Embedded-3/iGuard/images/project_picture.png

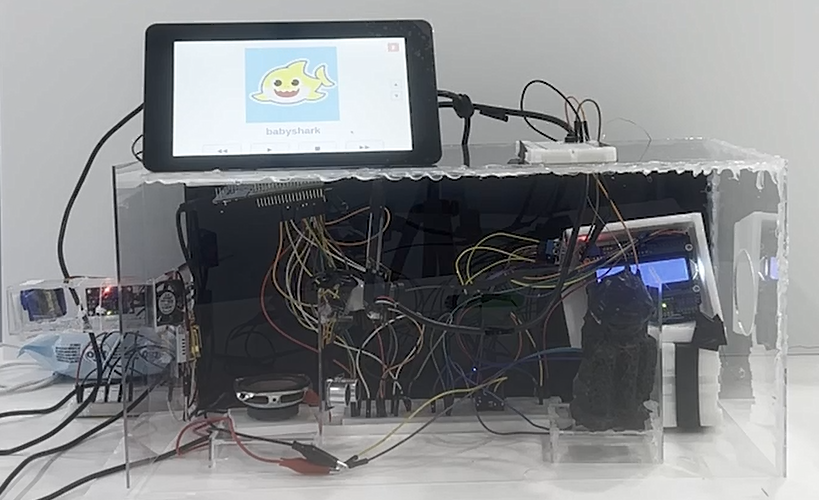
images/project_picture.png
