Embedded-3/iGuard/stm32_IVI/can_L0/Core/Inc/main.h

#define B1_Pin GPIO_PIN_13
#define B1_GPIO_Port GPIOC
#define B1_EXTI_IRQn EXTI4_15_IRQn
#define MCO_Pin GPIO_PIN_0
#define MCO_GPIO_Port GPIOH
#define USART_TX_Pin GPIO_PIN_2
#define USART_TX_GPIO_Port GPIOA
#define USART_RX_Pin GPIO_PIN_3
#define USART_RX_GPIO_Port GPIOA
#define LD2_Pin GPIO_PIN_5
#define LD2_GPIO_Port GPIOA
#define LCD_D6_Pin GPIO_PIN_10
#define LCD_D6_GPIO_Port GPIOB
#define LCD_E_Pin GPIO_PIN_7
#define LCD_E_GPIO_Port GPIOC
#define LCD_D7_Pin GPIO_PIN_8
#define LCD_D7_GPIO_Port GPIOA
#define LCD_RS_Pin GPIO_PIN_9
#define LCD_RS_GPIO_Port GPIOA
#define CAN_INT_Pin GPIO_PIN_10
#define CAN_INT_GPIO_Port GPIOA
#define CAN_INT_EXTI_IRQn EXTI4_15_IRQn
#define TMS_Pin GPIO_PIN_13
#define TMS_GPIO_Port GPIOA
#define TCK_Pin GPIO_PIN_14
#define TCK_GPIO_Port GPIOA
#define LCD_D5_Pin GPIO_PIN_4
#define LCD_D5_GPIO_Port GPIOB
#define LCD_D4_Pin GPIO_PIN_5
#define LCD_D4_GPIO_Port GPIOB
#define CAN_CS_Pin GPIO_PIN_6
#define CAN_CS_GPIO_Port GPIOB
