Embedded-3/iGuard/stm32_IVI/can_L0/Core/Src/main.c

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
/* Includes ------------------------------------------------------------------*/
#include "main.h"
#include "spi.h"
#include "usart.h"
#include "gpio.h"

/* USER CODE BEGIN Includes */
#include "CANSPI.h"
#include "lcd.h"
#include "stdio.h"
#include "MCP2515.h"
#include "DFPLAYER_MINI.h"
#include "string.h"
#include "hw_vcom.h"
/* USER CODE END Includes */

/* USER CODE BEGIN PD */
#define BUFSIZE 128
/* USER CODE END PD */


/* USER CODE BEGIN PV */
extern UART_HandleTypeDef huart2; // USART2
extern UART_HandleTypeDef huart4; // USART4
uCAN_MSG rxMessage;
/* USER CODE END PV */

void SystemClock_Config(void);
/* USER CODE BEGIN 0 */
volatile uint8_t can_rx_flag = 1;
volatile uint8_t driving_flag = 1;

void HAL_GPIO_EXTI_Callback(uint16_t GPIO_Pin)
{
	 if (GPIO_Pin == CAN_INT_Pin)  // PB9 INT
    {
				can_rx_flag = 1;
				HAL_ResumeTick();
    }
}
/* USER CODE END 0 */

/**
  * @brief  The application entry point.
  * @retval int
  */
int main(void)
{

  /* MCU Configuration--------------------------------------------------------*/

  /* Reset of all peripherals, Initializes the Flash interface and the Systick. */
  HAL_Init();

  /* Configure the system clock */
  SystemClock_Config();

  /* Initialize all configured peripherals */
  MX_GPIO_Init();
  MX_SPI1_Init();
  MX_USART2_UART_Init();
  MX_USART4_UART_Init();
  /* USER CODE BEGIN 2 */
	HW_VCOM_Init(&huart2);
	DF_Init(20);
  CANSPI_Initialize();	
	lcd_init();
	
	MCP2515_EnableInterrupts();
	
	DF_Resume();
  Printf("DF_Init finished\r\n");
  HAL_Delay(100);  
	
	Sound_Track(1);
	HAL_Delay(100);
	
  DF_Pause(); // pause
  Printf("DF_Pause \r\n");
  HAL_Delay(1000);
	Printf("now int pin : %d\r\n", HAL_GPIO_ReadPin(CAN_INT_GPIO_Port, CAN_INT_Pin));
	Printf("now driving mode : %d\r\n", driving_flag);
  
  static int lcdCnt = 0;
	static char buf[32];
	static uint8_t musicNumber;
	/* USER CODE END 2 */

  /* Infinite loop */
  /* USER CODE BEGIN WHILE */
  while (1)
  {
		// sleeping_mode
		if (driving_flag == 0 && can_rx_flag)
		{
				can_rx_flag = 0; 
				while(CANSPI_messagesInBuffer() > 0)
				{
					if (CANSPI_Receive(&rxMessage))
					{
						// Set song number from Raspberry pi CAN messege !!!!!!!!!!!!
						// STM32 check
						switch (rxMessage.frame.id)
						{
							// wakeup message 
							case 0x1:
								Printf("Wake up Message Received\r\n");
								break;
							// TextLcd message
							case 0x10:
								// store 8 bytes to buf
								Printf("%d th PrintLcd Message Received\r\n", lcdCnt + 1);
								if (lcdCnt < 4)
								{
										buf[lcdCnt * 8 + 0] = rxMessage.frame.data0;
										buf[lcdCnt * 8 + 1] = rxMessage.frame.data1;
										buf[lcdCnt * 8 + 2] = rxMessage.frame.data2;
										buf[lcdCnt * 8 + 3] = rxMessage.frame.data3;
										buf[lcdCnt * 8 + 4] = rxMessage.frame.data4;
										buf[lcdCnt * 8 + 5] = rxMessage.frame.data5;
										buf[lcdCnt * 8 + 6] = rxMessage.frame.data6;
										buf[lcdCnt * 8 + 7] = rxMessage.frame.data7;

										lcdCnt++;
								}

								// print lcd
								if (lcdCnt == 4)
								{
										buf[31] = '\0';  // null-terminate
										Printf("Print Message : %s\r\n", buf);
										lcd_clear();
										lcd_goto(0, 0); 
										lcd_print((char*)buf);  // buf[0~15]

										lcd_goto(1, 0);
										lcd_print((char*)&buf[16]); // buf[16~31]

										lcdCnt = 0;  // clear buf
								}
								break;
							// DFPlayer StartMusic
							case 0x05:
								musicNumber = rxMessage.frame.data0;
								Printf("%d Music Starts\r\n", musicNumber);
								if (musicNumber >= 1 && musicNumber <= 3)
								{
									Sound_Track(musicNumber);
								}
								break;
							// DFPlayer EndMusic
							case 0x06:
								Printf("Music Pauses\r\n");
								DF_Pause();
								break;
							// Resume Music
							case 0x07:
								Printf("Music Resume\r\n");
								DF_Resume();
								break;
							// DFPlayer Volume Up
							case 0x08:
								Printf("Music Volume Up\r\n");
								DF_Volume_Up();
								break;
							// DFPlayer Volume Down
							case 0x09:
								Printf("Music Volume Down\r\n");
								DF_Volume_Down();
								break;
							//  Sleep Message
							case 0x02:
								Printf("Goes to Sleep\r\n");
								HAL_SuspendTick();
								HAL_PWR_EnterSLEEPMode(PWR_MAINREGULATOR_ON, PWR_SLEEPENTRY_WFI);
								break;
							default:
								Printf("Default : %d\r\n", rxMessage.frame.id);
								break;
						}
					}		
				}
		}
		// driving mode
		else if (driving_flag && can_rx_flag)
		{
			can_rx_flag = 0;
			while(CANSPI_messagesInBuffer() > 0)
				{
					if (CANSPI_Receive(&rxMessage))
					{
						// Set song number from Raspberry pi CAN messege !!!!!!!!!!!!
						// STM32 check
						switch (rxMessage.frame.id)
						{
							// wakeup message 
							case 0x1:
								Printf("Wake up Message Received\r\n");
								break;
							// TextLcd message
							case 0x10:
								// store 8 bytes to buf
								Printf("%d th PrintLcd Message Received\r\n", lcdCnt + 1);
								if (lcdCnt < 4)
								{
										buf[lcdCnt * 8 + 0] = rxMessage.frame.data0;
										buf[lcdCnt * 8 + 1] = rxMessage.frame.data1;
										buf[lcdCnt * 8 + 2] = rxMessage.frame.data2;
										buf[lcdCnt * 8 + 3] = rxMessage.frame.data3;
										buf[lcdCnt * 8 + 4] = rxMessage.frame.data4;
										buf[lcdCnt * 8 + 5] = rxMessage.frame.data5;
										buf[lcdCnt * 8 + 6] = rxMessage.frame.data6;
										buf[lcdCnt * 8 + 7] = rxMessage.frame.data7;

										lcdCnt++;
								}

								// print lcd
								if (lcdCnt == 4)
								{
										buf[31] = '\0';  // null-terminate
										Printf("Print Message : %s\r\n", buf);
										lcd_clear();
										lcd_goto(0, 0); 
										lcd_print((char*)buf);  // buf[0~15]

										lcd_goto(1, 0);
										lcd_print((char*)&buf[16]); // buf[16~31]

										lcdCnt = 0;  // clear buf
								}
								break;
							// DFPlayer StartMusic
							case 0x05:
								musicNumber = rxMessage.frame.data0;
								Printf("%d Music Starts\r\n", musicNumber);
								if (musicNumber >= 1 && musicNumber <= 3)
								{
									Sound_Track(musicNumber);
								}
								break;
							// DFPlayer EndMusic
							case 0x06:
								Printf("Music Pauses\r\n");
								DF_Pause();
								break;
							// Resume Music
							case 0x07:
								Printf("Music Resume\r\n");
								DF_Resume();
								break;
							// DFPlayer Volume Up
							case 0x08:
								Printf("Music Volume Up\r\n");
								DF_Volume_Up();
								break;
							// DFPlayer Volume Down
							case 0x09:
								Printf("Music Volume Down\r\n");
								DF_Volume_Down();
								break;
							//  Sleep Message
							case 0x02:
								Printf("Goes to Sleep\r\n");
								driving_flag = 0;
								HAL_SuspendTick();
								HAL_PWR_EnterSLEEPMode(PWR_MAINREGULATOR_ON, PWR_SLEEPENTRY_WFI);
								break;
							default:
								Printf("Defuault : %d\r\n", rxMessage.frame.id);
								break;
						}
					}		
				}
		}
  }
    /* USER CODE END WHILE */

}

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
