Embedded-3/iGuard/stm32_IVI/can_L0/Core/Src/MCP2515.c

/*
    (c) 2016 Microchip Technology Inc. and its subsidiaries. You may use this
    software and any derivatives exclusively with Microchip products.

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
    IN NO EVENT WILL MICROCHIP BE LIABLE FOR ANY INDIRECT, SPECIAL, PUNITIVE,
    INCIDENTAL OR CONSEQUENTIAL LOSS, DAMAGE, COST OR EXPENSE OF ANY KIND
    WHATSOEVER RELATED TO THE SOFTWARE, HOWEVER CAUSED, EVEN IF MICROCHIP HAS
    BEEN ADVISED OF THE POSSIBILITY OR THE DAMAGES ARE FORESEEABLE. TO THE
    FULLEST EXTENT ALLOWED BY LAW, MICROCHIP'S TOTAL LIABILITY ON ALL CLAIMS IN
    ANY WAY RELATED TO THIS SOFTWARE WILL NOT EXCEED THE AMOUNT OF FEES, IF ANY,
    THAT YOU HAVE PAID DIRECTLY TO MICROCHIP FOR THIS SOFTWARE.

    MICROCHIP PROVIDES THIS SOFTWARE CONDITIONALLY UPON YOUR ACCEPTANCE OF THESE
    TERMS.
*/

#include "MCP2515.h"
#include "gpio.h"

/* SPI related variables */
extern SPI_HandleTypeDef        hspi1;
#define SPI_CAN                 &hspi1
#define SPI_TIMEOUT             10
#define MCP2515_CS_HIGH()   HAL_GPIO_WritePin(CAN_CS_GPIO_Port, CAN_CS_Pin, GPIO_PIN_SET)
#define MCP2515_CS_LOW()    HAL_GPIO_WritePin(CAN_CS_GPIO_Port, CAN_CS_Pin, GPIO_PIN_RESET)

/* Prototypes */
static void SPI_Tx(uint8_t data);
static void SPI_TxBuffer(uint8_t *buffer, uint8_t length);
static uint8_t SPI_Rx(void);
static void SPI_RxBuffer(uint8_t *buffer, uint8_t length);

/* initialize MCP2515 */
bool MCP2515_Initialize(void)
{
  MCP2515_CS_HIGH();    
  
  uint8_t loop = 10;
  
  do {
    /* check SPI Ready */
    if(HAL_SPI_GetState(SPI_CAN) == HAL_SPI_STATE_READY)
      return true;
    
    loop--;
  } while(loop > 0);

  // 초기화 시점: 수신된 메시지 내용은 무시하고 플래그만 정리
  MCP2515_BitModify(MCP2515_CANINTF, 0x03, 0x00); // RX0IF | RX1IF 클리어

  return false;
}

/* change mode as configuration mode */
bool MCP2515_SetConfigMode(void)
{
  /* configure CANCTRL Register */
  MCP2515_WriteByte(MCP2515_CANCTRL, 0x80);
  
  uint8_t loop = 10;
  
  do {    
    /* confirm mode configuration */
    if((MCP2515_ReadByte(MCP2515_CANSTAT) & 0xE0) == 0x80)
      return true;
    
    loop--;
  } while(loop > 0); 
  
  return false;
}

/* change mode as normal mode */
bool MCP2515_SetNormalMode(void)
{
  /* configure CANCTRL Register */
  MCP2515_WriteByte(MCP2515_CANCTRL, 0x00);
  
  uint8_t loop = 10;
  
  do {    
    /* confirm mode configuration */
    if((MCP2515_ReadByte(MCP2515_CANSTAT) & 0xE0) == 0x00)
      return true;
    
    loop--;
  } while(loop > 0);
  
  return false;
}

/* Entering sleep mode */
bool MCP2515_SetSleepMode(void)
{
  /* configure CANCTRL Register */
  MCP2515_WriteByte(MCP2515_CANCTRL, 0x20);
  
  uint8_t loop = 10;
  
  do {    
    /* confirm mode configuration */
    if((MCP2515_ReadByte(MCP2515_CANSTAT) & 0xE0) == 0x20)
      return true;
    
    loop--;
  } while(loop > 0);
  
  return false;
}

/* MCP2515 SPI-Reset */
void MCP2515_Reset(void)
{    
  MCP2515_CS_LOW();
      
  SPI_Tx(MCP2515_RESET);
      
  MCP2515_CS_HIGH();
}

/* read single byte */
uint8_t MCP2515_ReadByte (uint8_t address)
{
  uint8_t retVal;
  
  MCP2515_CS_LOW();
  
  SPI_Tx(MCP2515_READ);
  SPI_Tx(address);
  retVal = SPI_Rx();
      
  MCP2515_CS_HIGH();
  
  return retVal;
}

/* read buffer */
void MCP2515_ReadRxSequence(uint8_t instruction, uint8_t *data, uint8_t length)
{
  MCP2515_CS_LOW();
  
  SPI_Tx(instruction);        
  SPI_RxBuffer(data, length);
    
  MCP2515_CS_HIGH();
}

/* write single byte */
void MCP2515_WriteByte(uint8_t address, uint8_t data)
{    
  MCP2515_CS_LOW();  
  
  SPI_Tx(MCP2515_WRITE);
  SPI_Tx(address);
  SPI_Tx(data);  
    
  MCP2515_CS_HIGH();
}

/* write buffer */
void MCP2515_WriteByteSequence(uint8_t startAddress, uint8_t endAddress, uint8_t *data)
{    
  MCP2515_CS_LOW();
  
  SPI_Tx(MCP2515_WRITE);
  SPI_Tx(startAddress);
  SPI_TxBuffer(data, (endAddress - startAddress + 1));
  
  MCP2515_CS_HIGH();
}

/* write to TxBuffer */
void MCP2515_LoadTxSequence(uint8_t instruction, uint8_t *idReg, uint8_t dlc, uint8_t *data)
{    
  MCP2515_CS_LOW();
  
  SPI_Tx(instruction);
  SPI_TxBuffer(idReg, 4);
  SPI_Tx(dlc);
  SPI_TxBuffer(data, dlc);
       
  MCP2515_CS_HIGH();
}

/* write to TxBuffer(1 byte) */
void MCP2515_LoadTxBuffer(uint8_t instruction, uint8_t data)
{
  MCP2515_CS_LOW();
  
  SPI_Tx(instruction);
  SPI_Tx(data);
        
  MCP2515_CS_HIGH();
}

/* request to send */
void MCP2515_RequestToSend(uint8_t instruction)
{
  MCP2515_CS_LOW();
  
  SPI_Tx(instruction);
      
  MCP2515_CS_HIGH();
}

/* read status */
uint8_t MCP2515_ReadStatus(void)
{
  uint8_t retVal;
  
  MCP2515_CS_LOW();
  
  SPI_Tx(MCP2515_READ_STATUS);
  retVal = SPI_Rx();
        
  MCP2515_CS_HIGH();
  
  return retVal;
}

/* read RX STATUS register */
uint8_t MCP2515_GetRxStatus(void)
{
  uint8_t retVal;
  
  MCP2515_CS_LOW();
  
  SPI_Tx(MCP2515_RX_STATUS);
  retVal = SPI_Rx();
        
  MCP2515_CS_HIGH();
  
  return retVal;
}

/* Use when changing register value */
void MCP2515_BitModify(uint8_t address, uint8_t mask, uint8_t data)
{    
  MCP2515_CS_LOW();
  
  SPI_Tx(MCP2515_BIT_MOD);
  SPI_Tx(address);
  SPI_Tx(mask);
  SPI_Tx(data);
        
  MCP2515_CS_HIGH();
}

/* SPI Tx wrapper function  */
static void SPI_Tx(uint8_t data)
{
  HAL_SPI_Transmit(SPI_CAN, &data, 1, SPI_TIMEOUT);    
}

/* SPI Tx wrapper function */
static void SPI_TxBuffer(uint8_t *buffer, uint8_t length)
{
  HAL_SPI_Transmit(SPI_CAN, buffer, length, SPI_TIMEOUT);    
}

/* SPI Rx wrapper function */
static uint8_t SPI_Rx(void)
{
  uint8_t retVal;
  HAL_SPI_Receive(SPI_CAN, &retVal, 1, SPI_TIMEOUT);
  return retVal;
}

/* SPI Rx wrapper function */
static void SPI_RxBuffer(uint8_t *buffer, uint8_t length)
{
  HAL_SPI_Receive(SPI_CAN, buffer, length, SPI_TIMEOUT);
}

/* HyunHo Custom */
#define MCP2515_READ_RX_BUFFER_0  0x90  // Read RX Buffer 0: Start from RXB0SIDH
#define MCP2515_READ_RX_BUFFER_1  0x94  // Read RX Buffer 1: Start from RXB1SIDH
void MCP2515_EnableInterrupts(void)
{
    // SET RX0IE | RX1IE bit to 1(0x01 | 0x02 = 0x03)
    MCP2515_WriteByte(MCP2515_CANINTE, 0x03);
}


void MCP2515_ReadCANMessage(void)
{
    uint8_t intf = MCP2515_ReadByte(MCP2515_CANINTF);

    if (intf & 0x01)  // RX0IF
    {
        uint8_t data[13];  // SIDH, SIDL, EID8, EID0, DLC, data(8???)
        MCP2515_ReadRxSequence(MCP2515_READ_RX_BUFFER_0, data, 13);

        MCP2515_BitModify(MCP2515_CANINTF, 0x01, 0x00);  // RX0IF 
    }

    if (intf & 0x02)  // RX1IF
    {
        uint8_t data[13];
        MCP2515_ReadRxSequence(MCP2515_READ_RX_BUFFER_1, data, 13);
			
        MCP2515_BitModify(MCP2515_CANINTF, 0x02, 0x00);  // RX1IF 
    }
}
