Embedded-3/iGuard/tc275_hvac/asclin_driver/asclin.c

// asclin.c
#include <asclin_driver/asclin.h>
#include "Ifx_Types.h"
#include "IfxAsclin_Asc.h"
#include "Ifx_Shell.h"
#include "Ifx_Console.h"
#include "IfxPort.h"



// Global variables
IfxStdIf_DPipe  g_ascStandardInterface;                                     /* Standard interface object            */
IfxAsclin_Asc   g_asclin;                                                   /* ASCLIN module object                 */
Ifx_Shell       g_shellInterface;                                           /* Shell interface object               */

uint8 g_uartTxBuffer[ASC_TX_BUFFER_SIZE + sizeof(Ifx_Fifo) + 8];
uint8 g_uartRxBuffer[ASC_RX_BUFFER_SIZE + sizeof(Ifx_Fifo) + 8];


IfxStdIf_DPipe* stdif = &g_ascStandardInterface;    // To use other file

// Function Implementations
// IFX_INTERRUPT
IFX_INTERRUPT(asc3TxISR, 0, ISR_PRIORITY_ASCLIN_TX);

void asc3TxISR(void)
{
    IfxStdIf_DPipe_onTransmit(&g_ascStandardInterface);
}

IFX_INTERRUPT(asc3RxISR, 0, ISR_PRIORITY_ASCLIN_RX);

void asc3RxISR(void)
{
    IfxStdIf_DPipe_onReceive(&g_ascStandardInterface);
}

IFX_INTERRUPT(asc3ErrISR, 0, ISR_PRIORITY_ASCLIN_ER);

void asc3ErrISR(void)
{
    IfxStdIf_DPipe_onError(&g_ascStandardInterface);
}



void initShellInterface(void)
{
    /* Initialize the hardware peripherals */
    initSerialInterface();

    /* Initialize the Standard Interface */
    IfxAsclin_Asc_stdIfDPipeInit(&g_ascStandardInterface, &g_asclin);

    /* Initialize the Console */
    Ifx_Console_init(&g_ascStandardInterface);

    /* Print info to the console */
    printInfo(&g_ascStandardInterface);
}


void initSerialInterface(void)
{
    IfxAsclin_Asc_Config ascConf;

    /* Set default configurations */
    IfxAsclin_Asc_initModuleConfig(&ascConf, &MODULE_ASCLIN3); /* Initialize the structure with default values      */

    /* Set the desired baud rate */
    ascConf.baudrate.baudrate = ASC_BAUDRATE;                                   /* Set the baud rate in bit/s       */
    ascConf.baudrate.oversampling = IfxAsclin_OversamplingFactor_16;            /* Set the oversampling factor      */

    /* Configure the sampling mode */
    ascConf.bitTiming.medianFilter = IfxAsclin_SamplesPerBit_three;             /* Set the number of samples per bit*/
    ascConf.bitTiming.samplePointPosition = IfxAsclin_SamplePointPosition_8;    /* Set the first sample position    */

    /* ISR priorities and interrupt target */
    ascConf.interrupt.txPriority = ISR_PRIORITY_ASCLIN_TX;  /* Set the interrupt priority for TX events             */
    ascConf.interrupt.rxPriority = ISR_PRIORITY_ASCLIN_RX;  /* Set the interrupt priority for RX events             */
    ascConf.interrupt.erPriority = ISR_PRIORITY_ASCLIN_ER;  /* Set the interrupt priority for Error events          */
    ascConf.interrupt.typeOfService = IfxSrc_Tos_cpu0;

    /* Pin configuration */
    const IfxAsclin_Asc_Pins pins = {
            .cts        = NULL_PTR,                         /* CTS pin not used                                     */
            .ctsMode    = IfxPort_InputMode_pullUp,
            .rx         = &IfxAsclin3_RXD_P32_2_IN ,        /* Select the pin for RX connected to the USB port      */
            .rxMode     = IfxPort_InputMode_pullUp,         /* RX pin                                               */
            .rts        = NULL_PTR,                         /* RTS pin not used                                     */
            .rtsMode    = IfxPort_OutputMode_pushPull,
            .tx         = &IfxAsclin3_TX_P15_7_OUT,         /* Select the pin for TX connected to the USB port      */
            .txMode     = IfxPort_OutputMode_pushPull,      /* TX pin                                               */
            .pinDriver  = IfxPort_PadDriver_cmosAutomotiveSpeed1
    };
    ascConf.pins = &pins;

    /* FIFO buffers configuration */
    ascConf.txBuffer = g_uartTxBuffer;                      /* Set the transmission buffer                          */
    ascConf.txBufferSize = ASC_TX_BUFFER_SIZE;              /* Set the transmission buffer size                     */
    ascConf.rxBuffer = g_uartRxBuffer;                      /* Set the receiving buffer                             */
    ascConf.rxBufferSize = ASC_RX_BUFFER_SIZE;              /* Set the receiving buffer size                        */

    /* Init ASCLIN module */
    IfxAsclin_Asc_initModule(&g_asclin, &ascConf);          /* Initialize the module with the given configuration   */
}


void printInfo(IfxStdIf_DPipe *io)
{
    IfxStdIf_DPipe_print(io, ENDLINE);
    IfxStdIf_DPipe_print(io, "******************************************************************************"ENDLINE);
    IfxStdIf_DPipe_print(io, "[ Serial DEBUG ]  "ENDLINE);
    IfxStdIf_DPipe_print(io, "******************************************************************************"ENDLINE);
}
