Embedded-3/iGuard/tc275_hvac/mq135_driver/mq135.c

// mq135.c

#include "mq135.h"


static void Driver_Adc0_Init(void);

App_VadcAutoScan g_VadcAutoScan;
IfxVadc_Adc_ChannelConfig adcChannelConfig[8];
IfxVadc_Adc_Channel   adcChannel[8];
uint16 adcDataResult[8] = {0u,};

// 핀 설정 : 핀 A2
uint32 chnIx = 5; //7;
uint16 groutId = IfxVadc_GroupId_4;



static void Driver_Adc0_Init(void)
{
    /* VADC Configuration */

    /* create configuration */
    IfxVadc_Adc_Config adcConfig;
    IfxVadc_Adc_initModuleConfig(&adcConfig, &MODULE_VADC);

    /* initialize module */
    IfxVadc_Adc_initModule(&g_VadcAutoScan.vadc, &adcConfig);

    /* create group config */
    IfxVadc_Adc_GroupConfig adcGroupConfig;
    IfxVadc_Adc_initGroupConfig(&adcGroupConfig, &g_VadcAutoScan.vadc);

    /* with group 0 */
    adcGroupConfig.groupId = groutId;   // groupId 4
    adcGroupConfig.master  = adcGroupConfig.groupId;

    /* enable scan source */
    adcGroupConfig.arbiter.requestSlotScanEnabled = TRUE;

    /* enable auto scan */
    adcGroupConfig.scanRequest.autoscanEnabled = TRUE;

    /* enable all gates in "always" mode (no edge detection) */
    adcGroupConfig.scanRequest.triggerConfig.gatingMode = IfxVadc_GatingMode_always;

    /* initialize the group */
    /*IfxVadc_Adc_Group adcGroup;*/    //declared globally
    IfxVadc_Adc_initGroup(&g_VadcAutoScan.adcGroup, &adcGroupConfig);

    /*channel init*/
    IfxVadc_Adc_initChannelConfig(&adcChannelConfig[chnIx], &g_VadcAutoScan.adcGroup);

    adcChannelConfig[chnIx].channelId      = (IfxVadc_ChannelId)(chnIx);
    adcChannelConfig[chnIx].resultRegister = (IfxVadc_ChannelResult)(chnIx);  /* use dedicated result register */

    /* initialize the channel */
    IfxVadc_Adc_initChannel(&adcChannel[chnIx], &adcChannelConfig[chnIx]);

    /* add to scan */
    unsigned channels = (1 << adcChannelConfig[chnIx].channelId);
    unsigned mask     = channels;
    IfxVadc_Adc_setScan(&g_VadcAutoScan.adcGroup, channels, mask);

}


void Driver_MQ135_Init(void)
{
    /*ADC0 Converter Init*/
    Driver_Adc0_Init();

    /*ADC0 Converter Start*/
    Driver_Adc0_ConvStart();
}

void Driver_Adc0_ConvStart(void)
{
    /* start autoscan */
    IfxVadc_Adc_startScan(&g_VadcAutoScan.adcGroup);
}

uint16 Driver_Adc0_DataObtain(void)
{
    Ifx_VADC_RES conversionResult; /* wait for valid result */

    /* check results */
    do
    {
        conversionResult = IfxVadc_Adc_getResult(&adcChannel[chnIx]);
    } while (!conversionResult.B.VF);

    adcDataResult[chnIx] = conversionResult.B.RESULT;
    return adcDataResult[chnIx];
}
