Embedded-3/iGuard/stm32_boot/can_L0/Core/Src/main.c

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
/* Includes ------------------------------------------------------------------*/
#include "main.h"
#include "adc.h"
#include "spi.h"
#include "tim.h"
#include "usart.h"
#include "gpio.h"

/* USER CODE BEGIN Includes */
#include "CANSPI.h"
#include "MCP2515.h"
#include "stdio.h"
#include "string.h"
/* USER CODE END Includes */


/* USER CODE BEGIN PV */

volatile uCAN_MSG rxMessage;
extern ADC_HandleTypeDef hadc;
volatile float Vout;

volatile static uint32_t dDist = 0;

volatile uint8_t DistanceReady = 0;
volatile uint16_t no_activity_counter = 0;
volatile uint8_t tim3_flag = 0;

volatile uint8_t driving_mode = 1; // driving mode
/* USER CODE END PV */

void SystemClock_Config(void);
/* USER CODE BEGIN PFP */
void delay (uint16_t time);
void HAL_TIM_IC_CaptureCallback(TIM_HandleTypeDef *htim);
void HCSR04_Read(void);
uint8_t FSR_Check (void);
uint8_t Ultrasonic_Check(void);
void check_and_send(void);
void send_sleep_message(void);
void send_wakeup_message(void);
void enter_sleep_mode(void);
/* USER CODE END PFP */

/* USER CODE BEGIN 0 */
void HAL_GPIO_EXTI_Callback(uint16_t GPIO_Pin)
{
	 if (GPIO_Pin == EXTERNAL_BUTTON_Pin)  // external button
    {
				HAL_GPIO_TogglePin(GPIOA, GPIO_PIN_5);
			  send_sleep_message();
				driving_mode = 0; // car poweroff
    }
}
uint32_t cnt2 = 0;
/* USER CODE END 0 */

/**
  * @brief  The application entry point.
  * @retval int
  */
int main(void)
{

  /* MCU Configuration--------------------------------------------------------*/

  /* Reset of all peripherals, Initializes the Flash interface and the Systick. */
  HAL_Init();

  /* Configure the system clock */
  SystemClock_Config();

  /* Initialize all configured peripherals */
  MX_GPIO_Init();
  MX_SPI1_Init();
  MX_USART2_Init();
  MX_ADC_Init();
  MX_TIM2_Init();
  MX_TIM3_Init();
  /* USER CODE BEGIN 2 */
  CANSPI_Initialize();	
	HAL_TIM_IC_Start_IT(&htim2, TIM_CHANNEL_3);
  HAL_TIM_Base_Start_IT(&htim3);
	__HAL_TIM_DISABLE_IT(&htim2, TIM_IT_CC3);
  /* USER CODE END 2 */

  /* Infinite loop */
  /* USER CODE BEGIN WHILE */
	HCSR04_Read();
  while (1) {
    if (driving_mode == 0 && tim3_flag) {
      tim3_flag = 0;
      check_and_send();  
    }
  }
    /* USER CODE END WHILE */

}

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
/* USER CODE BEGIN 4 */
void delay (uint16_t time)
{
    __HAL_TIM_SET_COUNTER(&htim2, 0);
    while (__HAL_TIM_GET_COUNTER (&htim2) < time);
}

void HAL_TIM_PeriodElapsedCallback(TIM_HandleTypeDef *htim)
{
  if(htim->Instance == htim3.Instance){
    tim3_flag= 1;
  }
}
volatile static float Distance  = 0;
void HAL_TIM_IC_CaptureCallback(TIM_HandleTypeDef *htim) // 초음파 센서 거리 계산 비동기 로직
{ // INT when detected Ultrasound sig
		volatile static uint32_t IC_Val1 = 0;
		volatile static uint32_t IC_Val2 = 0;
		volatile static uint8_t Is_First_Captured = 0;  // is the first value captured 
		static uint32_t prevDiff = 0;
		volatile static uint32_t currDiff = 0;
		
    if (htim->Channel == HAL_TIM_ACTIVE_CHANNEL_3)  // if the interrupt source is channel1
    {
        if (Is_First_Captured==0) // if the first value is not captured
        {
            IC_Val1 = HAL_TIM_ReadCapturedValue(htim, TIM_CHANNEL_3); // read the first value
            Is_First_Captured = 1; 
            __HAL_TIM_SET_CAPTUREPOLARITY(htim, TIM_CHANNEL_3, TIM_INPUTCHANNELPOLARITY_FALLING);
        }
        else if (Is_First_Captured==1)   // if the first is already captured
        {
            IC_Val2 = HAL_TIM_ReadCapturedValue(htim, TIM_CHANNEL_3);  // read second value
            __HAL_TIM_SET_COUNTER(htim, 0);  // reset the counter

            if (IC_Val2 > IC_Val1)
            {
                currDiff = IC_Val2-IC_Val1;
            }
            else if (IC_Val1 > IC_Val2)
            {
                currDiff = (0xffff - IC_Val1) + IC_Val2;
            }
						
						dDist = (prevDiff > currDiff) ? (prevDiff - currDiff) : (currDiff - prevDiff);

						prevDiff = currDiff;
            Distance = ((currDiff * 340)/1000)/2;
						
            DistanceReady = 1;
            Is_First_Captured = 0; 
						
            __HAL_TIM_SET_CAPTUREPOLARITY(htim, TIM_CHANNEL_3, TIM_INPUTCHANNELPOLARITY_RISING);
            __HAL_TIM_DISABLE_IT(&htim2, TIM_IT_CC3);
        }
    }
}

void send_sleep_message(void)
{
		uCAN_MSG txMessage;
    txMessage.frame.idType = dSTANDARD_CAN_MSG_ID_2_0B;
    txMessage.frame.id = 0x2; // sleep message id = 2
    txMessage.frame.dlc = 8;
    txMessage.frame.data0 = 's';
    txMessage.frame.data1 = 'l';
    txMessage.frame.data2 = 'e';
    txMessage.frame.data3 = 'e';
    txMessage.frame.data4 = 'p';
    txMessage.frame.data5 = 0;
    txMessage.frame.data6 = 0;
    txMessage.frame.data7 = 0;

    CANSPI_Transmit(&txMessage);
    HAL_GPIO_TogglePin(GPIOA, GPIO_PIN_5);
}

void send_wakeup_message(void)
{
		uCAN_MSG txMessage;
    txMessage.frame.idType = dSTANDARD_CAN_MSG_ID_2_0B;
    txMessage.frame.id = 0x1; // wakeup message id = 1
    txMessage.frame.dlc = 8;
    txMessage.frame.data0 = 'W';
    txMessage.frame.data1 = 'A';
    txMessage.frame.data2 = 'K';
    txMessage.frame.data3 = 'E';
    txMessage.frame.data4 = 0;
    txMessage.frame.data5 = 0;
    txMessage.frame.data6 = 0;
    txMessage.frame.data7 = 0;

    CANSPI_Transmit(&txMessage);
    HAL_GPIO_TogglePin(GPIOA, GPIO_PIN_5);
}

void enter_sleep_mode(void) 
{
  HAL_SuspendTick(); 
  HAL_PWR_EnterSLEEPMode(PWR_MAINREGULATOR_ON, PWR_SLEEPENTRY_WFI);
  HAL_ResumeTick();   
}


void HCSR04_Read(void)
{
	HAL_GPIO_WritePin(GPIOB,GPIO_PIN_4,GPIO_PIN_SET);
	delay(10);
	HAL_GPIO_WritePin(GPIOB,GPIO_PIN_4,GPIO_PIN_RESET);

	__HAL_TIM_ENABLE_IT(&htim2, TIM_IT_CC3);
}


uint8_t Ultrasonic_Check(void) {
  DistanceReady = 0;
  HCSR04_Read();
  uint32_t timeout = 0; 
  while (!DistanceReady && timeout < 60) {
		delay(1000);
		timeout++;
  }

  return (dDist > 0x30) ? 1 : 0;
}

uint8_t PIR_Check(void) {
  GPIO_PinState state = HAL_GPIO_ReadPin(GPIOB, GPIO_PIN_5);  // PIR 센서 핀
  return (state == GPIO_PIN_SET) ? 1 : 0;
}

uint8_t FSR_Check(void){
	uint32_t adcValue;
	HAL_ADC_Start(&hadc);
	HAL_ADC_PollForConversion(&hadc, 1000);
	adcValue = HAL_ADC_GetValue(&hadc); // ADC
	HAL_ADC_Stop(&hadc);
	
	Vout = (adcValue / 4095.0f) * 5.0f;    // VOUT  (5V )
  return (Vout > 1.0f) ? 1 : 0;
}
uint8_t pir;
void check_and_send(void) {
	uint8_t ultrasonic = Ultrasonic_Check();

  uint8_t fsr = FSR_Check();
  pir = PIR_Check();  
  uint8_t result = fsr && (pir || ultrasonic); // Sensor Logic
	
	// result accumulated stores last 3 results
	static uint8_t result_accumulated = 0;
	
	static uint8_t cnt_1s = 0; // cnt_1s counts for 3 second.
	static uint8_t sleep_message_sent = 0; // sleep message sent -> sleeps all other ECUs
	static uint8_t wake_message_sent = 0;
	cnt_1s++;
	// stores result to result_accumulated	
	result_accumulated |= result;
	// no_activity_counter counts for N seconds
	no_activity_counter++;
	
	// if 3 seconds 
	if (cnt_1s == 3)
	{
		if (result_accumulated)
		{
			if(wake_message_sent == 0)
			{ // wake only once
				wake_message_sent = 1;
				send_wakeup_message();
			}
      no_activity_counter = 0;
			result_accumulated = 0;
			sleep_message_sent = 0;
		}
		cnt_1s = 0;
	}

	// if CANT find child in 30seconds -> send sleep message to All other ECUs
  if (no_activity_counter >= 600 && sleep_message_sent == 0) {
		// sleep message send
	  send_sleep_message();
    no_activity_counter = 0;
		sleep_message_sent = 1;
    //enter_sleep_mode();
  }
}

/* USER CODE END 4 */
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
