Embedded-3/iGuard/(commit log)

2025-04-28 Add files via upload
    보드에 load 할 때 debug 할 때만 load 가 됨. 이유를 아직 못 찾았음.
2025-04-28 DP-23 <feat : pwm>
2025-04-29 DP-28 <init : STM32 to STM32>
2025-04-29 DP-16 <PC->TC275깨우기 성공. 폴더 이름 바꿈>
2025-04-29 DP-24 <feat : develop fan pwm>
2025-04-29 DP-28 <STM wakeup error>
    [can_L0.ioc, main.c, main.h]
2025-04-29 DP-16 <삭제된거복구>
2025-04-29 DP-28 <STM32 sleep wake complete>
2025-04-30 DP-28 <STM SPI complete>
2025-04-30 DP-34 <feat: hvac 제어 알고리즘 ver.1>
2025-04-30 DP-24 <feat : pwm level>
2025-04-30 DP-30 feat HC-SR501 sensor
2025-04-30 DP-30 feat HC-SR04 sensor
2025-04-30 DP-40 <testing to stop df>
    문제점: df가 한번 시작하면 reset 해도 계속 작동중
    [DFPLAYER_MINI.c, main.c]
2025-04-30 DP-50 <DP-31과 병합테스트>
2025-04-30 DP-30 feat add timer interrupt htim3
2025-04-30 DP-50 <stm_main에 sensor 이식>
2025-04-30 DP-34 <feat: 공조시스템 제어 알고리즘v2>
2025-04-30 DP-54 <feat : SERVO_PWM>
2025-04-30 DP-50 <STM sensor 1초 동기화 완료>
2025-05-01 DP-56 <STM32 아이 감지 TEMP>
2025-05-01 DP-57 <feat: mhz19b 체크섬 및 UART 타임아웃 기능 추가>
2025-05-02 DP-56 <IVI STM 수정>
    [main.c]
2025-05-02 DP-55 <통합 완료>
2025-05-02 DP-34 <fix : PWM.c/PWM.h>
    [PWM.c, PWM.h]
2025-05-02 DP-60 <1차통합>
2025-05-02 DP-60 <STM32 IVI 병합1>
2025-05-02 DP-58 <feat : 공조 시스템 통합 완료>
2025-05-02 DP-63 <feat: 공조 시스템에 CAN 적용>
2025-05-02 DP-42 <통합 및 MP3 LCD CAN 명령 받고 음악재생 lcd출력완료>
2025-05-06 DP-22 <feat: uart 통신 코드 수정>
    [mhz19b.c]
2025-05-06 코드 다듬기
2025-05-07 DP-42 <병합 완료 코드 세부 수정>
    [main.c]
2025-05-07 DP-60 <default can message id 출력 설정>
2025-05-07 DP-60 <TC275폴더 삭제>
2025-05-07 DP-58 <feat : 공조 시스템 통합 완료3>
2025-05-07 Overwrite main with contents of DP-17-공조-시스템-개발
2025-05-07 DP-70 <CANDB업로드>
2025-05-07 DP-70 <Sleep Message 수신 시 sleep 추가>
2025-05-07 DP-72 <feat: hvac 모드에 따른 LED 추가 >
2025-05-07 DP-39 <현재까진 진단기 수준, 음량 조절, 음악 조절 버튼도 추가됨>
2025-05-07 Revert "DP-39 <현재까진 진단기 수준, 음량 조절, 음악 조절 버튼도 추가됨>"
2025-05-08 DP-70 <driving<-> sleep mode 추가>
2025-05-08 DP-71 <sleep message 송신 추가 및 3초에 한번씩 wake up message 보냄>
2025-05-08 DP-71 <초기상태 driving, 버튼(PA8)누르면 sleep message 전송해서 시동 끔>
2025-05-08 DP-70 <처음에 재움>
2025-05-08 DP-70 <stm32IVI 오류 수정 -> 처음에는 driving mode>
    [main.c]
2025-05-09 DP-70 <자잘한 것 수정>
    [main.c]
2025-05-09 DP-69 <센서값 세부 조정 완료>
2025-05-09 DP-75 <feat : 자동 모드일때 팬 속도 제어 뛰어 넘기>
2025-05-10 DP-70 <DFMini 명령어 추가>
2025-05-10 DP-69 <내부 세부 조정2>
2025-05-10 DP-70 <candb 삭제>
2025-05-10 DP-70 <candb 추가>
2025-05-10 DP-86 <ㄴsound track 최적화>
2025-05-12 DP-69 <세부 조정3>
2025-05-12 DP-86 <딜레이 추가>
2025-05-12 DP-88 <readme 1차추가>
2025-05-12 DP-88 <readme 수정1차>
2025-05-12 DP-88 <2차수정>
2025-05-12 DP-88 <3차수정>
2025-05-12 DP-88 <4차변경>
2025-05-12 DP-88 <5차>
2025-05-12 DP-88 <6차수정>
2025-05-12 DP-88 <7차수정>
2025-05-12 DP-88 <제목수정>
2025-05-12 DP-88 <썸네일추가>
2025-05-12 DP-88 <링크로 수정>
